Gedas-dev/ncsender-plugin-vacuum-gauge/latest_release.md

## What's Changed

### ✨ New
- **Pin stays pinned** (ncSender Pro 2.0.317 or newer): a pinned mini gauge shows on every screen by itself, after a restart and on remote browsers too, until you unpin it
- **Size**: a Size slider in the Vacuum Gauge window makes the mini gauge smaller or larger
- The × on the mini gauge unpins it; the Pin / Unpin button in the Vacuum Gauge window does the same
- The style and size are plugin settings, so they are the same on every screen
- On ncSender without floating panels, the pinned mini gauge works as before, now with the Size slider

### 📦 Install
Download `community.vacuum-gauge_v1.3.0.zip` below. In ncSender open Plugins → Install from a ZIP file. Do not unzip it.
