Gedas-dev/ncsender-plugin-vacuum-gauge/(commit log)

2026-11-12 1.2.1: author, platform versions, SLB 5V wiring sheet, contributors, real-machine screenshot
    Claude-Session: https://claude.ai/code/session_019AaE9S2UHsPgxNiLVhLqH1
2026-11-12 Guide: add 'Power the ATOM Lite' page with SLB-EXT wiring
    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
2026-11-12 Remove separate power PDF; it is page 3 of the install guide
    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
2026-11-12 1.3.0-beta.2: pin/unpin and size for the mini gauge panel; remove extra panel button
    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
